ehotting/schakelbox/(commit log)

2026-03-25 fix: 4 bugs in schakellogica + btnVeld[2] initialisatie
    1. Storing-LED logica: knippert nu bij onopgeloste storing,
    continu aan bij opgeloste storing, uit bij inactieve knop.
    Gebruikt allSenseOk (storing 1) en allPairsOk (storing 2)
    ipv VS-stand.
    2. Koppelveld alarm: triggert nu fout als koppelveld uitschakelt
    terwijl beide RS (A+B of C+D) in een veld aan staan.
    Continue buzzer zolang situatie voortduurt.
    3. Rail-LED power flow model: bepaalt nu correct of 10kV-rails
    spanning hebben door de hele keten te volgen (50kV rail ->
    RS A/B -> VS prim -> VS sec -> RS C/D -> 10kV rail).
    Houdt rekening met beide koppelvelden.
    4. btnVeld[2] = false (was niet geinitialiseerd, g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
2026-03-25 feat: interactieve HTML/JS simulator van de schakelbox
    Virtuele simulatie met exact dezelfde logica als de Arduino code:
    - Alle schakelaars (RS, VS, koppelvelden) interactief
    - Power flow model voor rail-LED indicatie
    - Storing-simulatie met klikbare sense/pair verbindingen
    - Realistische CSS LED's met dome-effect en glow
    - Buzzer met Web Audio API (square wave + distortion + LFO pulsing)
    - Serial Monitor met debug output
2026-03-27 fix: buzzer triggert bij verlies van 10kV rail spanning
    Als een rail eerder spanning had en die valt weg (door ontkoppelen
    van een trafo), triggert nu triggerFault met buzzer. Zowel in
    Arduino code als simulator.
2026-04-09 feat: power-flow model rewrite met simulator en Arduino pinout
    V6: complete herschrijving van schakellogica naar power-flow model.
    V7: split-screen simulator met live Arduino Mega 2560 R3 pinout.
    Foutsoorten: schakelfout, uitval, railkoppeling, volgorde, foute pin.
    Features: spelscenario's, storing puzzels, aarding met kabel-UI,
    dubbele buzzer, rail/wijk LEDs, spannings/aardepunten.
2026-04-09 chore: opschonen repo, v7 als enige versie
    Oude bestanden verwijderd (v4/v5/v6), alleen v7 behouden.
    Hernoemd naar schakelbox_v7.ino en schakelbox_simulator_v7.html.
    README toegevoegd. DRY fixes, buzzer durations gelijkgetrokken,
    static vars naar globals, millis overflow fix.
    [schakelbox_v7.ino]
2026-04-09 feat: BDD tests met Gherkin in het Nederlands
    25 scenario's voor spanning, schakelfout, uitval, railkoppeling,
    volgorde en aarding. Kernlogica geextraheerd naar schakelbox_logic.js.
    Pre-commit hook draait tests automatisch.
2026-04-09 test: uitbreiding BDD tests naar 63 scenario's
    Spanning, schakelfout, uitval, railkoppeling, volgorde, aarding
    en randgevallen. Backfeed, meerdere trafos, koppelveld edge cases.
2026-04-28 feat: debounce digitale inputs tegen mains-hum pickup
    Filtert ruis op INPUT_PULLUP lijnen door inputs pas te accepteren als ze
    DEBOUNCE_MS (25 ms) stabiel zijn. Voorkomt valse triggers wanneer een
    hand bij de bananenstekkers komt.
    JS-port met 6 nieuwe BDD scenario's.
2026-04-28 fix: corrigeer pinout label voor 12V voeding aansluiting
    Het simulator-pinout zette '12V voed. GND' bij de 5V pin. Verplaatst
    naar de GND pin, en '12V voed. +' toegevoegd aan VIN.
    [schakelbox_v7.ino]
2026-04-28 fix: schakel optionele VOLT_SENSE check uit, bump V7.2
    Floating analog pin A0 pikte mains-hum op via hand-proximity en
    triggerde valse buzzer. VOLT_SENSE_ENABLED nu uit (was optioneel
    en niet bedraad). Bij heractivering vereist VOLT_SENSE_SAMPLES=10
    opeenvolgende samples boven threshold.
    [schakelbox_v7.ino]
2026-05-09 feat: V8 — toonsoort-buzzer, vlamboog-detectie, A0 als GND
    V7.2 → V8. Sketch en simulator hernoemd.
    Buzzer:
    - Passieve piezo via tone() ipv digitalWrite. Patronen per foutsoort:
    T1 uitval (perm), T2 aardpunt-kort (perm), T3 koppelveld (8s),
    T4 vlamboog/sad trombone (5s), T5 verloren (perm), T6 aarding (5s),
    T7 volgorde (3s), T8 boot (sync).
    - Highest-prio scheduler bij meerdere ongoing fouten (multiplex bleek
    onbruikbaar als geluid).
    - D7 (perm buzzer) afgeschaft, alles op D6.
    Detectie:
    - Case 2 (loskoppel-met-bypass) eruit: koppelveld vereffent spanning
    over rails dus RS schakelen onder bypass is veilig. Spanning-verschil
    blijft de enige trigger voor vlamboog.
    Storing-1 p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
    [schakelbox_v8.ino]
2026-05-09 feat: koppelveld-sync trigger met audio-visuele feedback
    Detectie: beide koppelvelden binnen 200 ms van elkaar geschakeld, 3×
    binnen 5 seconden. 10 s cooldown.
    Effect: 4 audio-sweeps (200 → 2000 Hz, 250 ms elk) en synchrone LED
    chase over alle 10 LEDs (rail + storing), afwisselend L→R en R→L.
    Normale outputs gepauzeerd zolang de sequence speelt (~1 s).
